Roshan-Industries/RAI-Flight_Computer-V1/04_Project_Images/04_Testing/FC_V1_Test_006_LANDED_Beacon_Active.jpg.jpeg

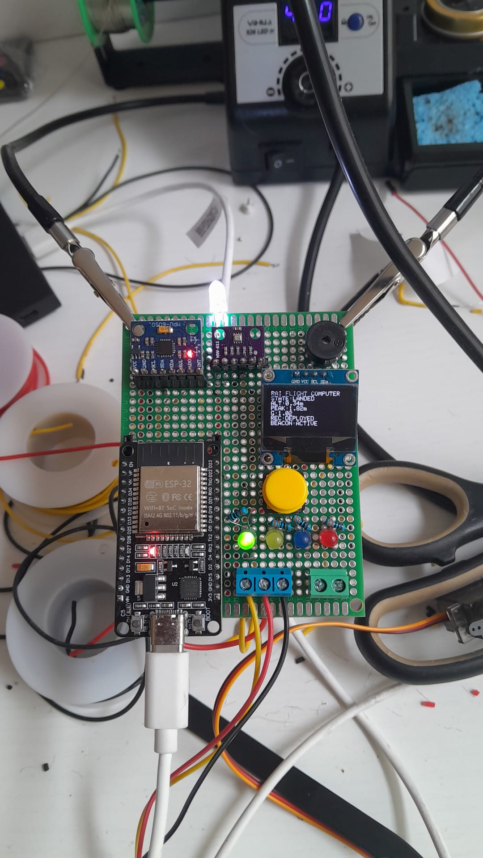
04_Project_Images/04_Testing/FC_V1_Test_006_LANDED_Beacon_Active.jpg.jpeg
