Roshan-Industries/RAI-Flight_Computer-V1/03_Hardware/04_Architecture/FC_V1_Hardware_Architecture.pdf.pdf

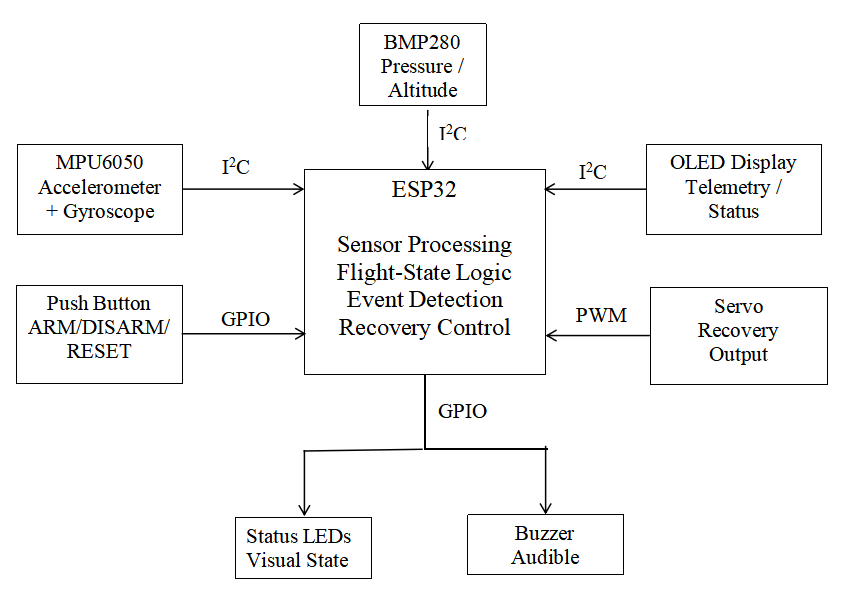
[picture p26: figure]
