Roshan-Industries/RAI-Flight_Computer-V1/04_Project_Images/01_Breadboard_prototype/FC_V1_Breadboard_004.jpg.jpeg

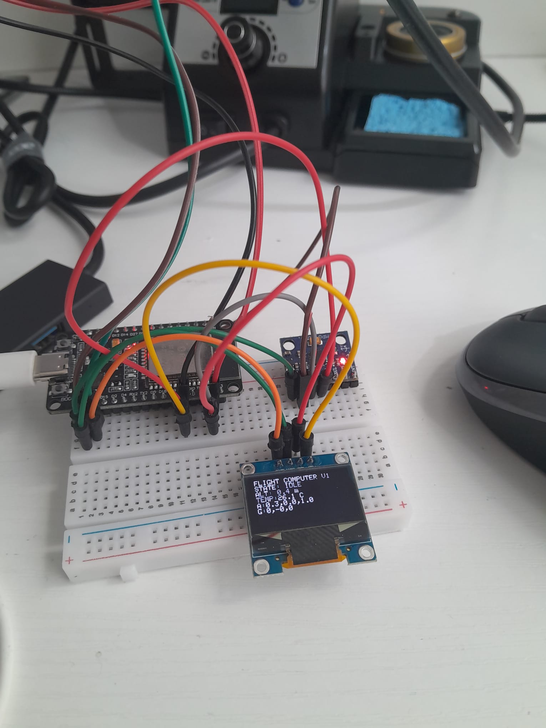
04_Project_Images/01_Breadboard_prototype/FC_V1_Breadboard_004.jpg.jpeg
