Roshan-Industries/RAI-Flight_Computer-V1/03_Hardware/01_Wiring_Diagrams/FC_V1_Wiring_Diagram.pdf.pdf

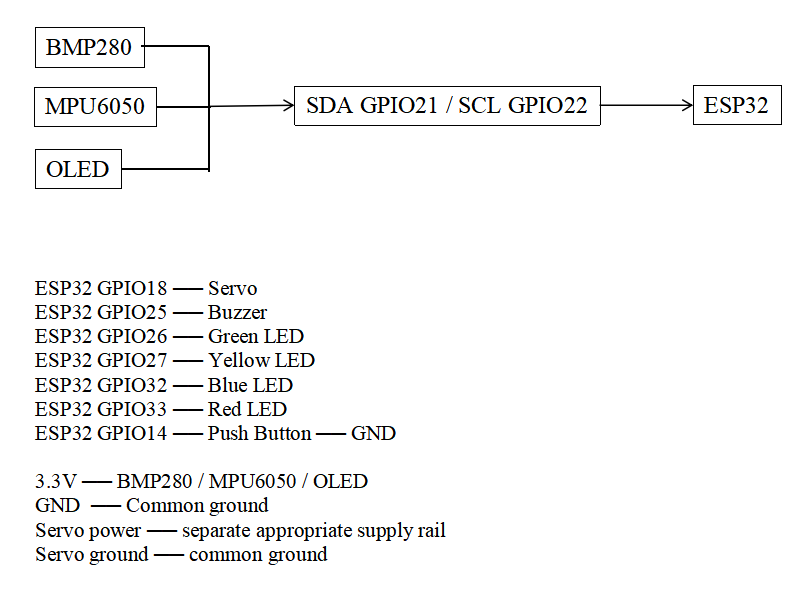
[picture p33: figure]
