Roshan-Industries/RAI-Flight_Computer-V1/04_Project_Images/02_Perfboard_Construction/FC_V1_Construction_005_Final_Assembly.jpg.jpeg

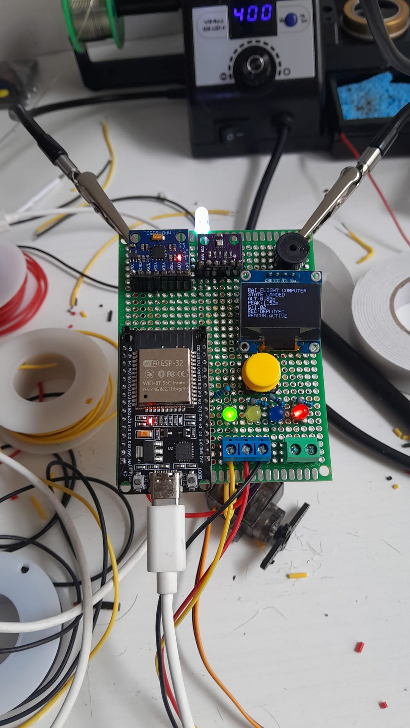
04_Project_Images/02_Perfboard_Construction/FC_V1_Construction_005_Final_Assembly.jpg.jpeg
