Roshan-Industries/RAI-Flight_Computer-V1/04_Project_Images/03_Final_Prototype/FC_V1_Final_Prototype_004_Solder_Side.jpg.jpeg

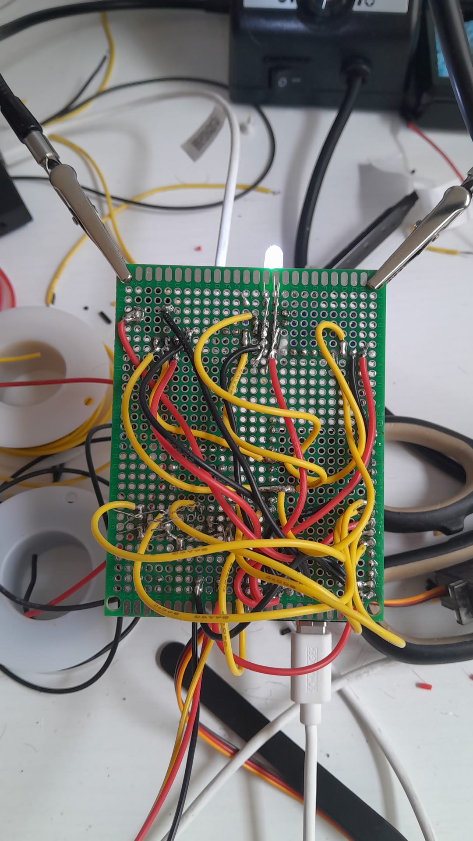
04_Project_Images/03_Final_Prototype/FC_V1_Final_Prototype_004_Solder_Side.jpg.jpeg
