Roshan-Industries/RAI-Flight_Computer-V1/04_Project_Images/04_Testing/FC_V1_Test_003_ASCENT.jpg.jpeg

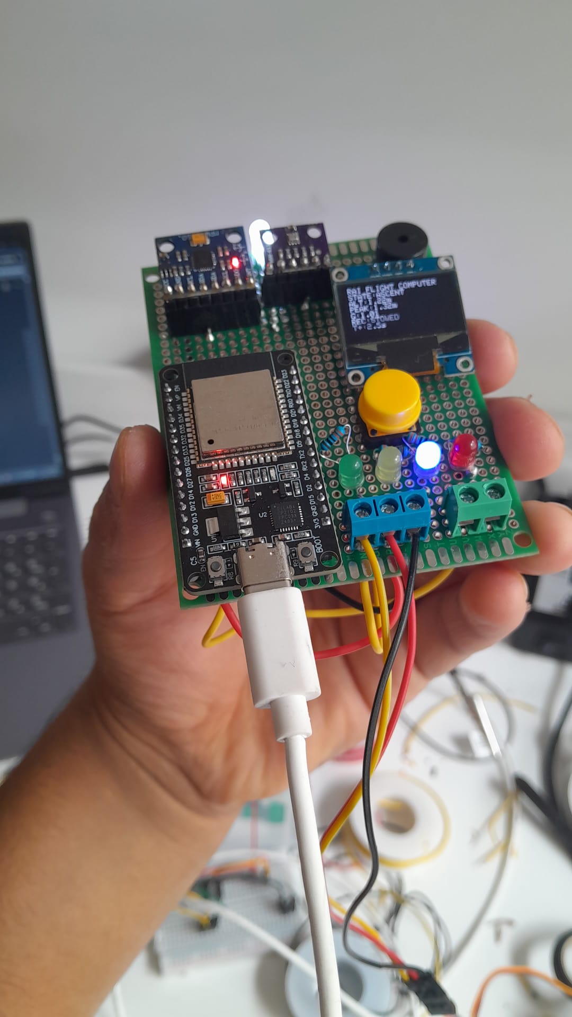
04_Project_Images/04_Testing/FC_V1_Test_003_ASCENT.jpg.jpeg
