Roshan-Industries/RAI-Flight_Computer-V1/02_Firmware/02_Development/01_Component_Test/Servo_Test.ino.ino

#include <ESP32Servo.h>

Servo servo;

void setup() {
  Serial.begin(115200);

  servo.attach(18);

  Serial.println("RAI SERVO TEST");

  servo.write(0);
  delay(2000);

  servo.write(90);
  delay(2000);

  servo.write(180);
  delay(2000);
}

void loop() {

  for (int pos = 0; pos <= 180; pos++) {
    servo.write(pos);
    delay(15);
  }

  for (int pos = 180; pos >= 0; pos--) {
    servo.write(pos);
    delay(15);
  }

}
