Roshan-Industries/RAI-Flight_Computer-V1/02_Firmware/02_Development/01_Component_Test/sketch_aug04a.ino

#define LED_BUILTIN 2

void setup() {
  pinMode(LED_BUILTIN, OUTPUT);

  Serial.begin(115200);
  Serial.println("RAI Flight Computer V1");
  Serial.println("ESP32 Bring-up Successful");
}

void loop() {
  digitalWrite(LED_BUILTIN, HIGH);
  Serial.println("LED ON");
  delay(1000);

  digitalWrite(LED_BUILTIN, LOW);
  Serial.println("LED OFF");
  delay(1000);
}
