Roshan-Industries/RAI-Flight_Computer-V1/02_Firmware/02_Development/01_Component_Test/sketch_jun19a.ino

#include<ESP32servo.h>

Servo myServo;
void setup(){
  myServo.attach(34);
  }

void loop(){
  myServo.write(0);
  delay(500);
  myServo.write(90);
  delay(500);
  myServo.write(180);
  delay(500);
  }
